NatsuDrag9/EVSE/assets/arch_and_flowchart/System_overview.jpg

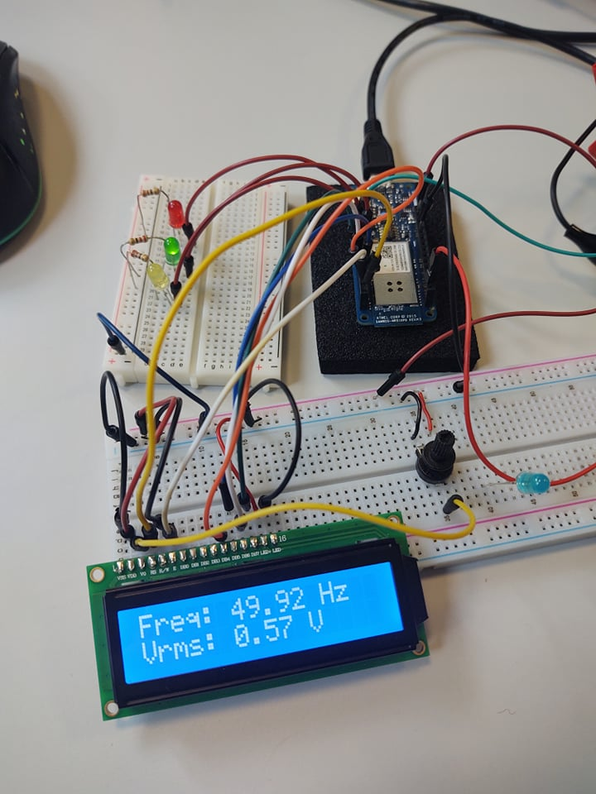
assets/arch_and_flowchart/System_overview.jpg
