NatsuDrag9/EVSE/assets/outputs/Oscilloscope2.jpg

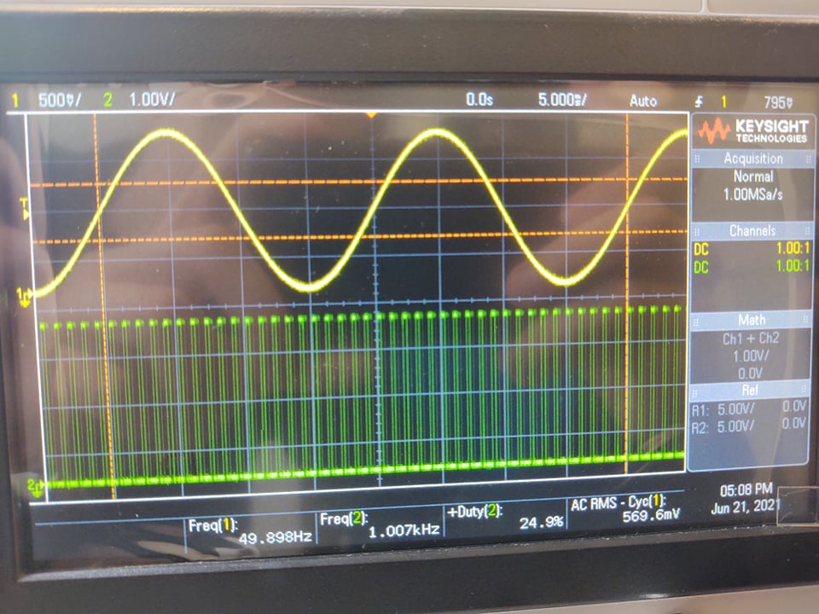
assets/outputs/Oscilloscope2.jpg
