NatsuDrag9/EVSE/code/ReadMe.adoc

:Author: Rohit
:Email:
:Date: 19/06/2021
:Revision: version1
:License: Public Domain

= Project: Frequncy Controlled Electric Vehicle Supply Equipment (EVSE)

This project implements a possible solution that monitors the power system’s frequency using Arduino MKR100. The application allows the electric vehicle owner (the user) to either opt for automatic charging or manually select the charging current remotely from a web application. The current charging the vehicle is controlled by the duty cycle of PWM signal generated by the micro-controller based on the IEC61851 standard.

== Step 1: Download the code folder

== Step 2: Assemble the circuit

Assemble the circuit according to the schematic shown below

https://github.com/NatsuDrag9/EVSE/blob/main/assets/arch_and_flowchart/Schematic_Connections.png

== Step 3: Load the code in Arduino IDE

Upload the code contained in this sketch on to Arduiono MKR 1000
