NatsuDrag9/EVSE/assets/arch_and_flowchart/Interrupt_Flow_Chart.png

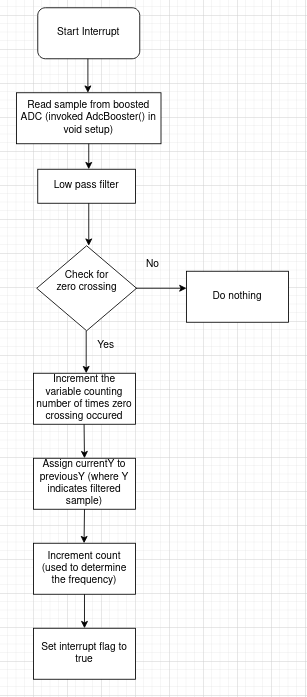
assets/arch_and_flowchart/Interrupt_Flow_Chart.png
