NatsuDrag9/EVSE/assets/arch_and_flowchart/Low_Pass_Filter.png

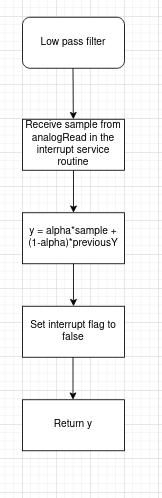
assets/arch_and_flowchart/Low_Pass_Filter.png
