NatsuDrag9/EVSE/assets/arch_and_flowchart/Set_PWM_Duty_Cycle.png

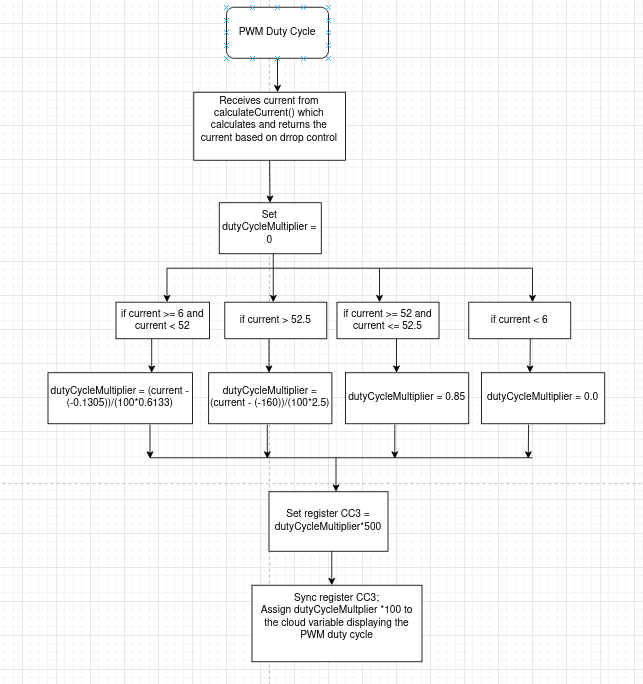
assets/arch_and_flowchart/Set_PWM_Duty_Cycle.png
