NatsuDrag9/EVSE/assets/outputs/Remote_Control_On_IoT_Dashboard.png

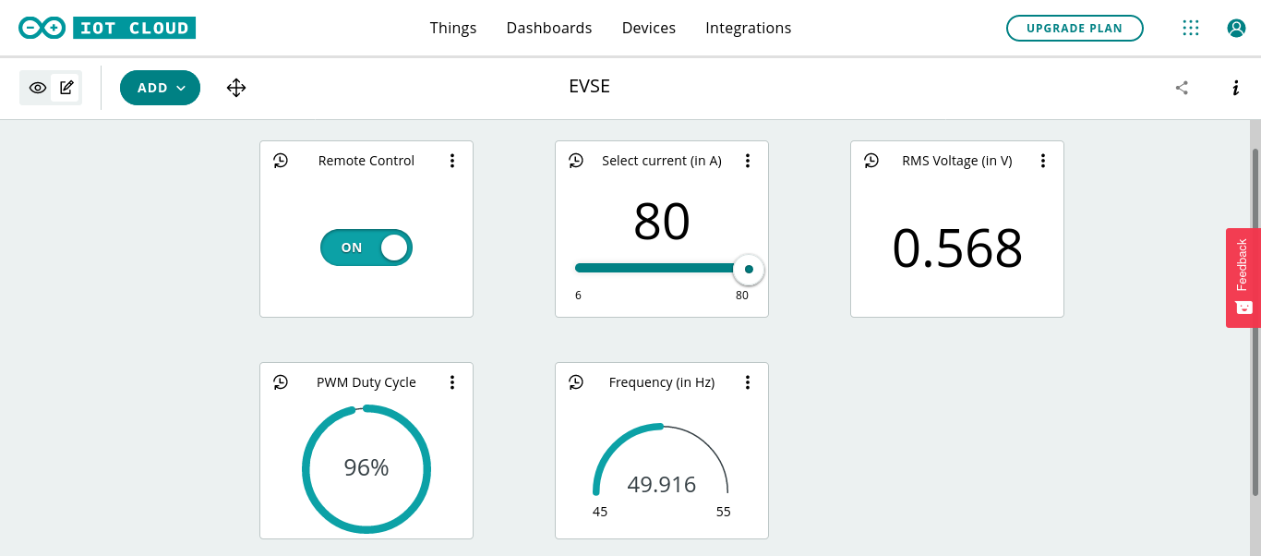
assets/outputs/Remote_Control_On_IoT_Dashboard.png
