NatsuDrag9/EVSE/(commit log)

2022-10-11 Added code, architecture, flowchart and project report
2023-09-06 Fixed schematic path
2024-06-09 Updated project title in arduino readme
